andrewcollison/HighTemp/HighTemp/PCB/finished photo.jpg

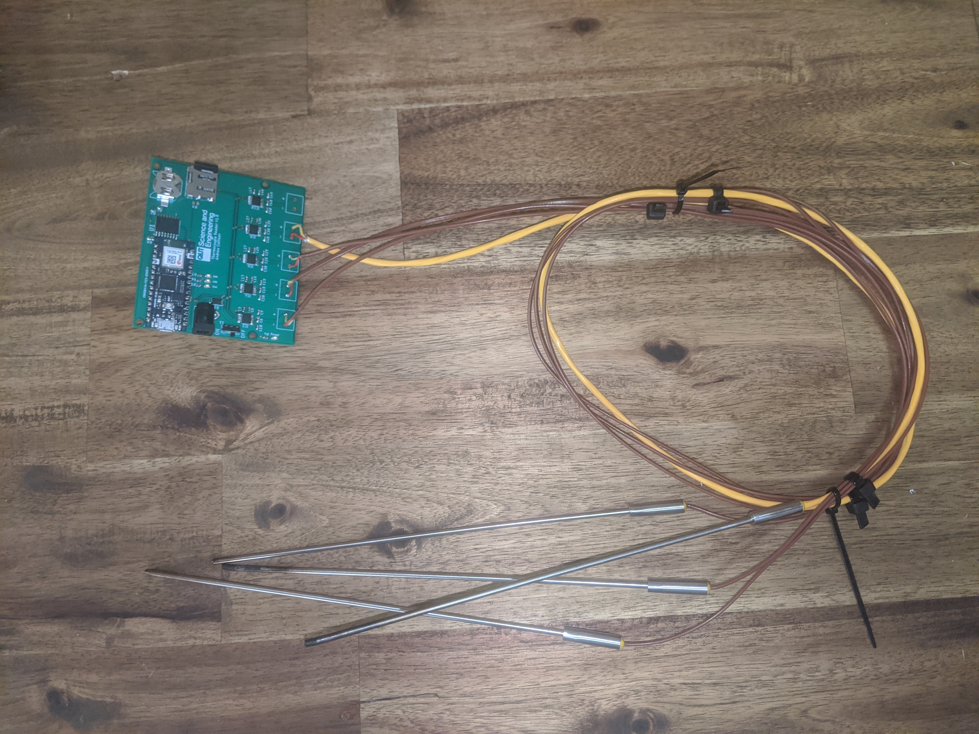
HighTemp/PCB/finished photo.jpg
