andrewcollison/HighTemp/HighTemp/Documentation/Capture.PNG

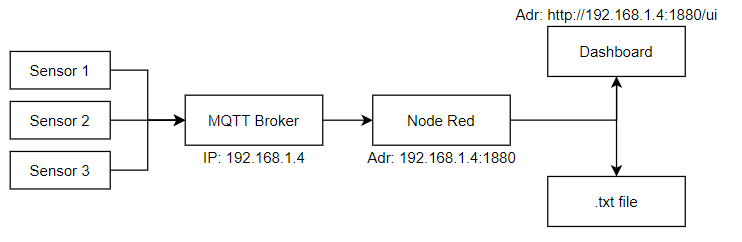
HighTemp/Documentation/Capture.PNG
