andrewcollison/HighTemp/HighTemp/Mechanical/mountingPlate.dxf

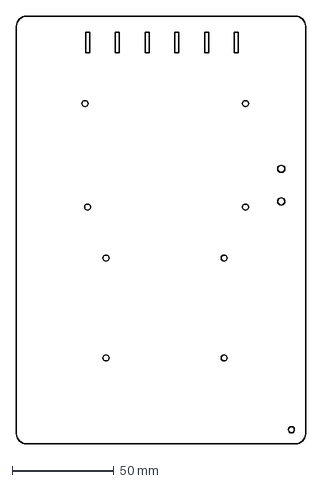
[picture p7: CAD file, 2020-08-11]
HighTemp/Mechanical/mountingPlate.dxf
142.0 x 210.0 mm
