andrewcollison/HighTemp/SaltLevel/CadModels/topAlignment.stl

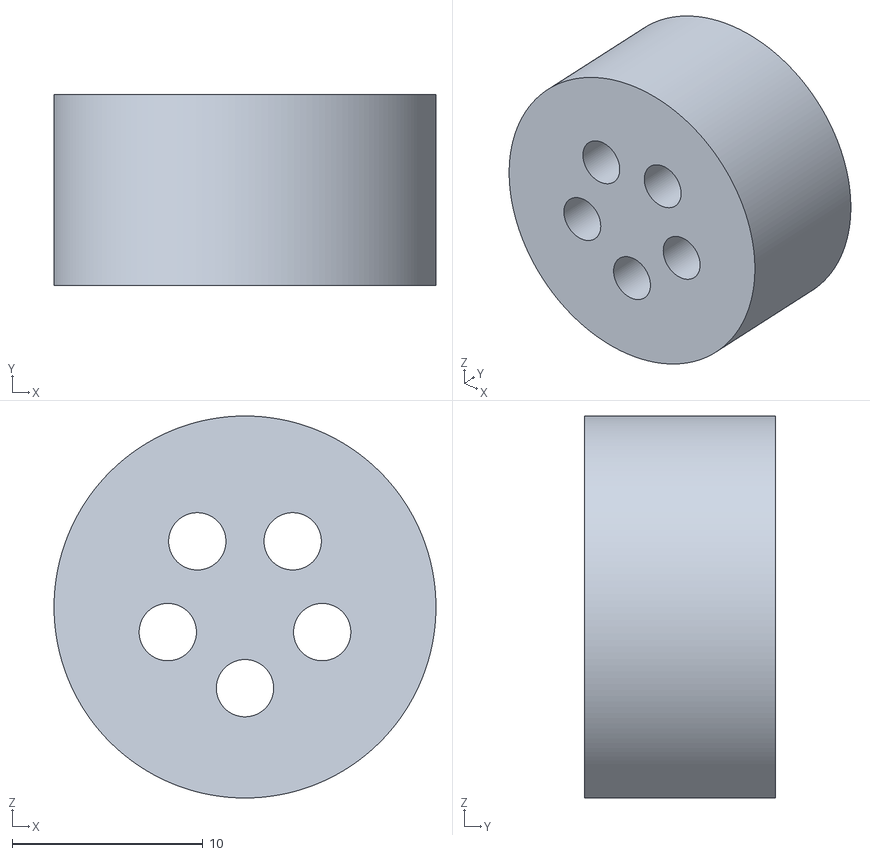
[picture p8: CAD file, 2021-02-08]
SaltLevel/CadModels/topAlignment.stl
20.0 x 10.0 x 20.0
