andrewcollison/HighTemp/SaltLevel/CadModels/BottomAlignment.stl

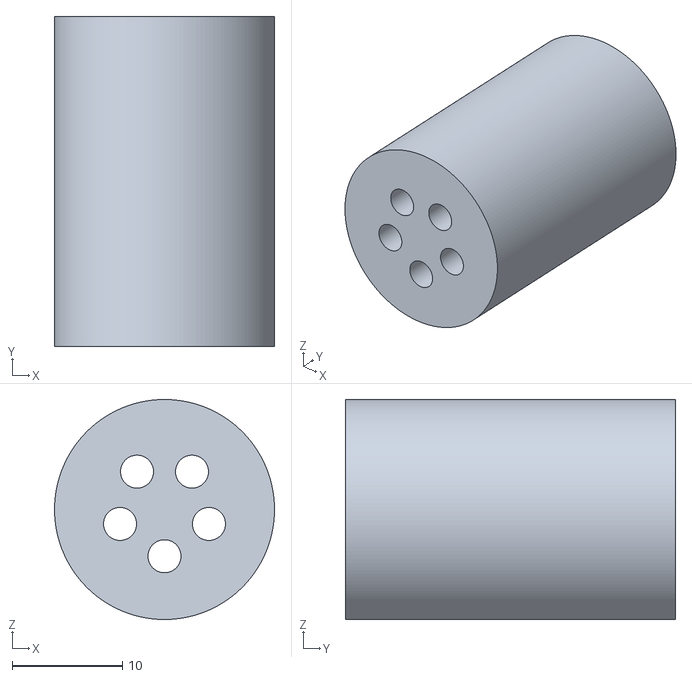
[picture p9: CAD file, 2021-02-08]
SaltLevel/CadModels/BottomAlignment.stl
20.0 x 30.0 x 20.0
