andrewcollison/HighTemp/SaltLevel/CadModels/probeAlignment.dxf

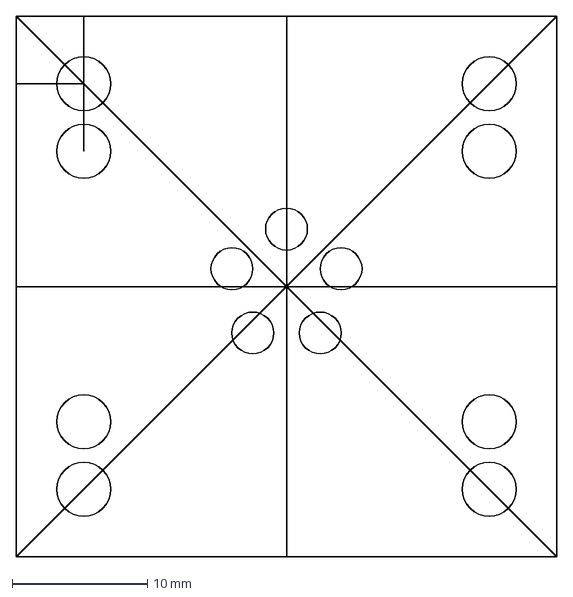
[picture p10: CAD file, 2021-02-08]
SaltLevel/CadModels/probeAlignment.dxf
40.0 x 40.0 mm
