andrewcollison/HighTemp/SaltLevel/CadModels/mouldLeft.stl

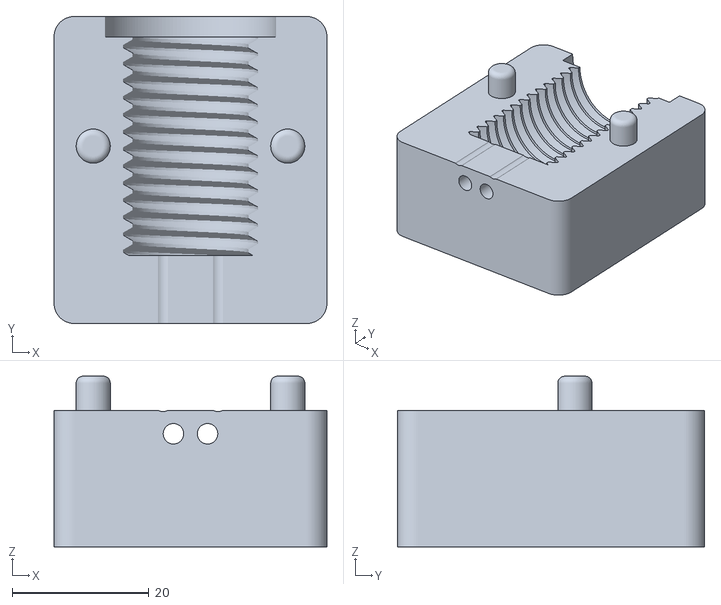
[picture p11: CAD file, 2021-02-03]
SaltLevel/CadModels/mouldLeft.stl
40.0 x 45.0 x 25.0
