andrewcollison/HighTemp/SaltLevel/CadModels/mouldRight.stl

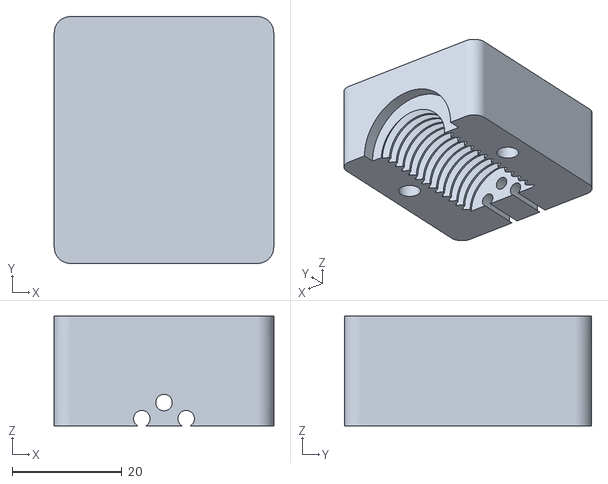
[picture p12: CAD file, 2021-02-03]
SaltLevel/CadModels/mouldRight.stl
40.0 x 45.0 x 20.0
