andrewcollison/HighTemp/(list of files, cad)

Other CAD files:
SaltLevel/CadModels/SaltLevelProbe v2.f3d
