andrewcollison/HighTemp/CentralNodeLogger/CalibrationTest/HeatingUp/dmmTempData.csv

Serial Number | MY59420041
Model Number | U1272A
Remark | -
Date Time | 3/10/2021 12:24:53 PM
Record | Time | Function | Reading | Range | Unit
1 | 3/10/2021 12:17:18.861 | Temperature {NONE} | 26.0 | °C | °C
2 | 3/10/2021 12:17:19.861 | Temperature {NONE} | 26.0 | °C | °C
3 | 3/10/2021 12:17:20.863 | Temperature {NONE} | 26.0 | °C | °C
4 | 3/10/2021 12:17:21.864 | Temperature {NONE} | 26.0 | °C | °C
5 | 3/10/2021 12:17:22.865 | Temperature {NONE} | 26.0 | °C | °C
6 | 3/10/2021 12:17:23.867 | Temperature {NONE} | 26.0 | °C | °C
7 | 3/10/2021 12:17:24.868 | Temperature {NONE} | 26.0 | °C | °C
8 | 3/10/2021 12:17:25.869 | Temperature {NONE} | 26.0 | °C | °C
9 | 3/10/2021 12:17:26.870 | Temperature {NONE} | 26.0 | °C | °C
10 | 3/10/2021 12:17:27.871 | Temperature {NONE} | 26.0 | °C | °C
11 | 3/10/2021 12:17:28.873 | Temperature {NONE} | 26.1 | °C | °C
12 | 3/10/2021 12:17:29.875 | Temperature {NONE} | 26.1 | °C | °C
13 | 3/10/2021 12:17:30.876 | Temperature {NONE} | 26.1 | °C | °C
14 | 3/10/2021 12:17:31.877 | Temperature {NONE} | 26.0 | °C | °C
15 | 3/10/2021 12:17:32.878 | Temperature {NONE} | 26.0 | °C | °C
16 | 3/10/2021 12:17:33.879 | Temperature {NONE} | 26.0 | °C | °C
17 | 3/10/2021 12:17:34.880 | Temperature {NONE} | 26.0 | °C | °C
18 | 3/10/2021 12:17:35.881 | Temperature {NONE} | 26.0 | °C | °C
19 | 3/10/2021 12:17:36.883 | Temperature {NONE} | 26.1 | °C | °C
20 | 3/10/2021 12:17:37.884 | Temperature {NONE} | 26.1 | °C | °C
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
305 | 3/10/2021 12:22:23.202 | Temperature {NONE} | 95.5 | °C | °C
306 | 3/10/2021 12:22:24.202 | Temperature {NONE} | 95.8 | °C | °C
307 | 3/10/2021 12:22:25.204 | Temperature {NONE} | 96.1 | °C | °C
308 | 3/10/2021 12:22:26.204 | Temperature {NONE} | 96.3 | °C | °C
309 | 3/10/2021 12:22:27.205 | Temperature {NONE} | 96.5 | °C | °C
310 | 3/10/2021 12:22:28.206 | Temperature {NONE} | 96.8 | °C | °C
311 | 3/10/2021 12:22:29.207 | Temperature {NONE} | 96.9 | °C | °C
312 | 3/10/2021 12:22:30.209 | Temperature {NONE} | 97.2 | °C | °C
313 | 3/10/2021 12:22:31.210 | Temperature {NONE} | 97.3 | °C | °C
314 | 3/10/2021 12:22:32.212 | Temperature {NONE} | 97.5 | °C | °C
315 | 3/10/2021 12:22:33.213 | Temperature {NONE} | 97.7 | °C | °C
316 | 3/10/2021 12:22:34.214 | Temperature {NONE} | 97.9 | °C | °C
317 | 3/10/2021 12:22:35.215 | Temperature {NONE} | 98.0 | °C | °C
