andrewcollison/HighTemp/HighTemp/Software/test1.png

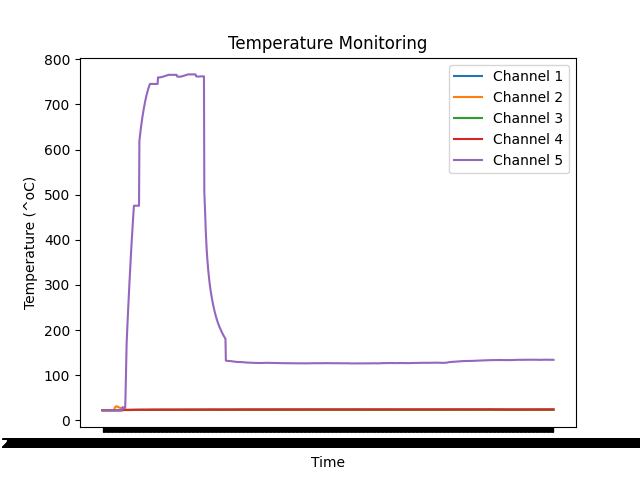
HighTemp/Software/test1.png
