andrewcollison/HighTemp/HighTemp/PCB/HighTempSCH.pdf

## Temperature Sensing

## Micro SD Storage

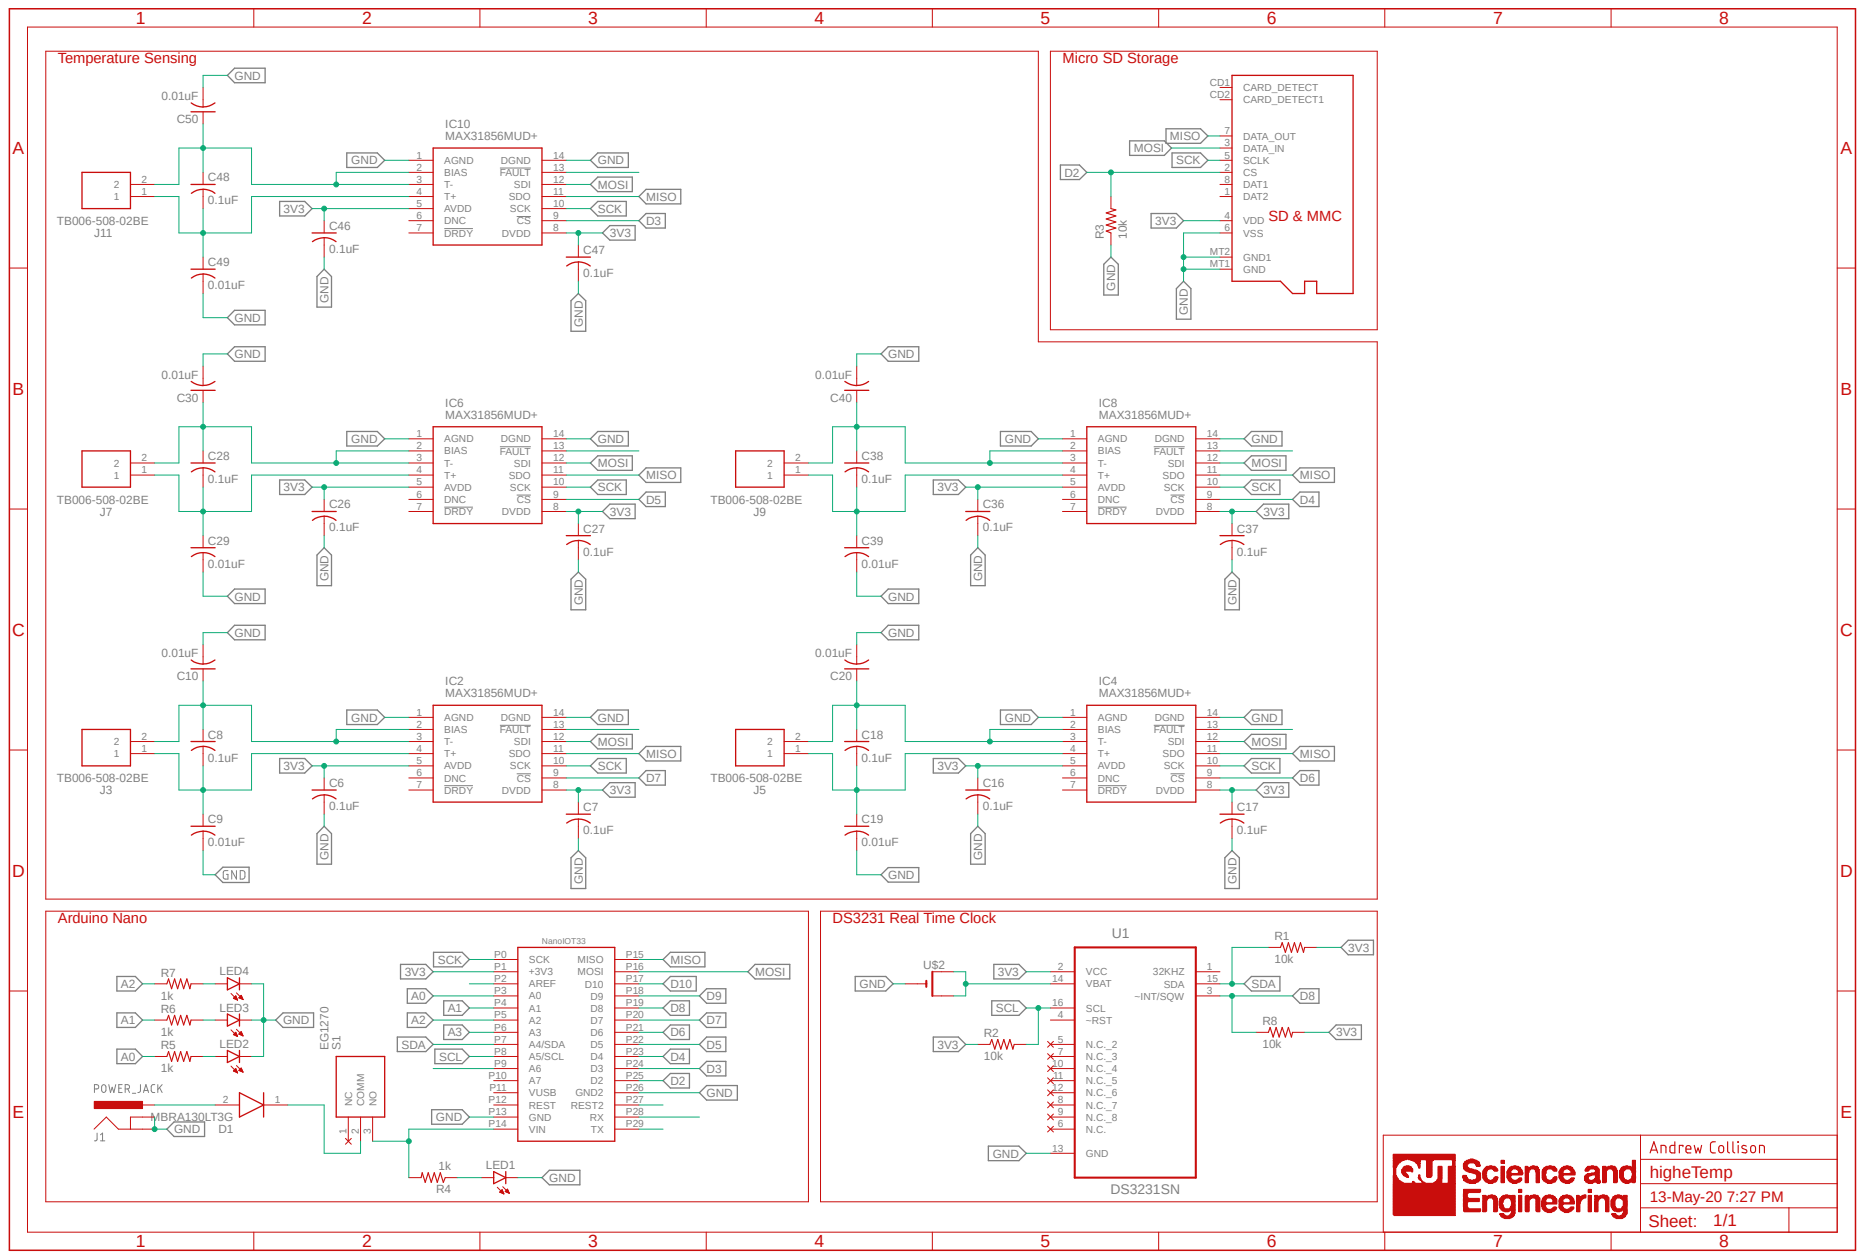
[picture p14: page 1]

AVDD 5
