andrewcollison/HighTemp/Pressure/VoltageScale.asc

R1: res; 47k
R2: res; 100k
V1: voltage; PULSE(1 5 0 10 0 0.1 1)
Named nets: sig, 0, A0
.tran 10
