andrewcollison/HighTemp/SaltLevel/SpiceSim/levelSense.asc

Q1: npn; 2N2222
R2: res; 10k
R3: res; 1k
S1: sw; MYSW
V1: voltage; PULSE(0 3.3 0 0.001 0.001 1 1 5)
V2: voltage; PULSE(0 3.3 1 0.001 0.001 1 2 5)
Named nets: 0, 3V3, D1, Von
.tran 10
.model MYSW SW(Ron=1 Roff=1Meg Vt=.5 Vh=-.4)
