andrewcollison/HighTemp/SaltCorrosion/SpiceSim/const_current.asc

Q1: npn; 2N2222
R1: res; 100k
R2: res; 100k
R5: res; {R}
R6: res; 2700
R9: res; 100k
R10: res; 100k
U1: LT1013
V1: voltage; 3.3
V2: voltage; 0.57
V4: voltage; 2.2
Named nets: 0, 3V3, ADC, VHigh, VLow, 2V2
.tran 10
.param R 10
