andrewcollison/HighTemp/HighTemp/PCB/higheTemp.brd

## EAGLE design HighTemp/PCB/higheTemp.brd (2020-07-14)

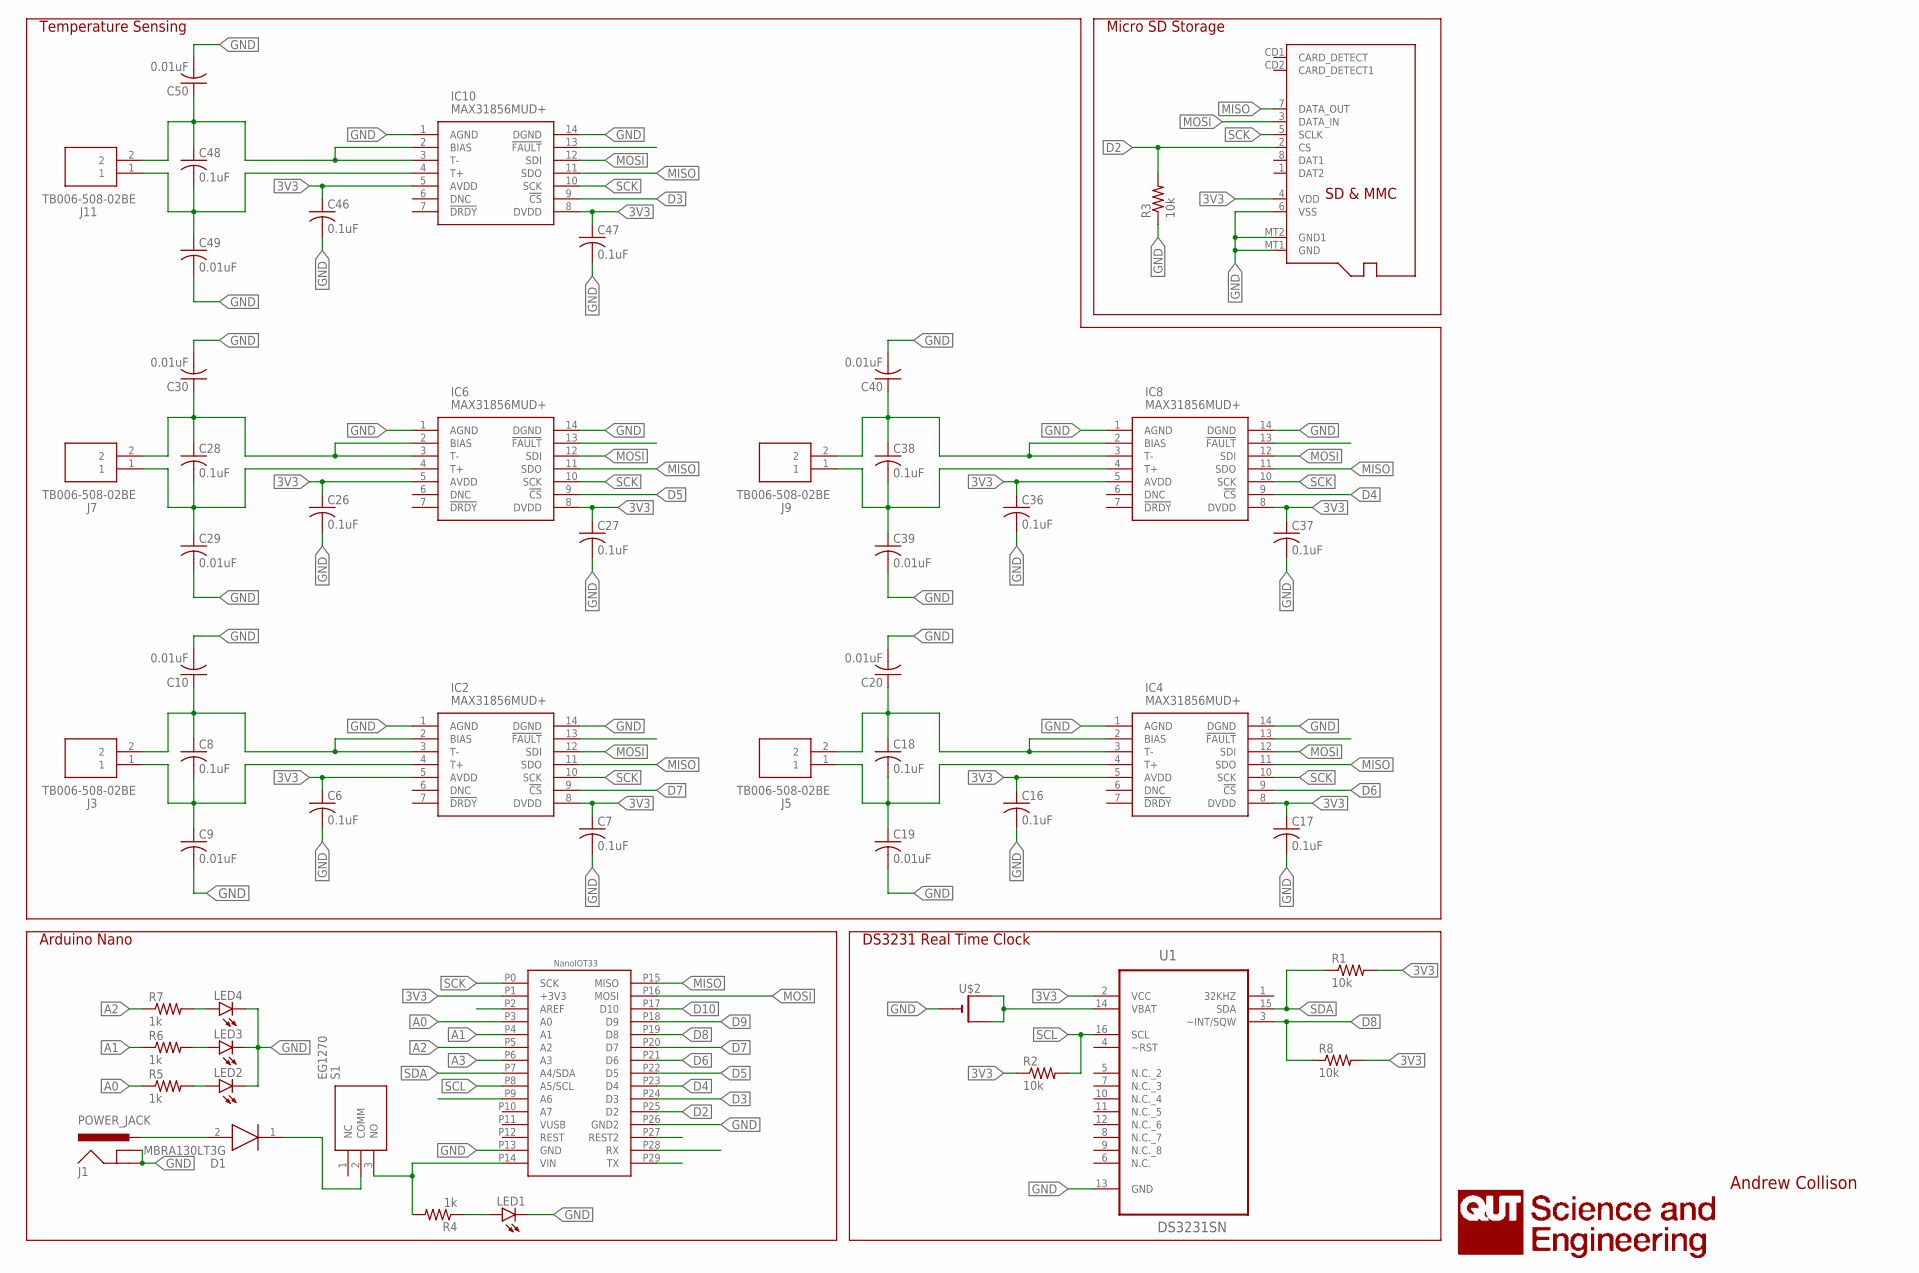
[picture p15: schematic higheTemp.sch]

Parts:
C6, C7, C8, C16, C17, C18, C26, C27, C28, C36, C37, C38, C46, C47, C48: 0.1uF; C0603
C9, C10, C19, C20, C29, C30, C39, C40, C49, C50: 0.01uF; C0603
D1: MBRA130LT3G; DIOM5226X220N
IC2, IC4, IC6, IC8, IC10: MAX31856MUD+; SOP65P640X110-14N
J1: POWER_JACK; POWER_JACK_PTH
J3, J5, J7, J9, J11: TB006-508-02BE; TB00650802BE
LED1, LED2, LED3, LED4: LEDCHIPLED_0805; CHIPLED_0805
R1, R2: 10k; R0603
R3, R8: 10k; R0805
R4, R5, R6, R7: 1k; R0603
S1: EG1270
U1: DS3231SN; SOIC127P1032X265-16N
U$1: NANO33IOT
U$2: CR1220SMT; CR1220-SMD
U$3: MICROSD

Connections:
3V3: C6.1, C7.1, C16.1, C17.1, C26.1, C27.1, C36.1, C37.1, C46.1, C47.1, IC2.5 (AVDD), IC2.8 (DVDD), IC4.5 (AVDD), IC4.8 (DVDD), IC6.5 (AVDD), IC6.8 (DVDD), IC8.5 (AVDD), IC8.8 (DVDD), IC10.5 (AVDD), IC10.8 (DVDD), R1.2, R2.1, R8.2, U1.2 (VCC), U$1.P1 (+3V3), U$3.4 (VDD)
A0: R5.1, U$1.P3 (A0)
A1: R6.1, U$1.P4 (A1)
A2: R7.1, U$1.P5 (A2)
A3: U$1.P6 (A3)
D2: R3.2, U$1.P25 (D2), U$3.2 (CS)
D3: IC10.9 (!CS), U$1.P24 (D3)
D4: IC8.9 (!CS), U$1.P23 (D4)
D5: IC6.9 (!CS), U$1.P22 (D5)
D6: IC4.9 (!CS), U$1.P21 (D6)
D7: IC2.9 (!CS), U$1.P20 (D7)
D8: R8.1, U1.3 (~INT/SQW), U$1.P19 (D8)
D9: U$1.P18 (D9)
D10: U$1.P17 (D10)
GND: C6.2, C7.2, C9.2, C10.2, C16.2, C17.2, C19.2, C20.2, C26.2, C27.2, C29.2, C30.2, C36.2, C37.2, C39.2, C40.2, C46.2, C47.2, C49.2, C50.2, IC2.1 (AGND), IC2.14 (DGND), IC4.1 (AGND), IC4.14 (DGND), IC6.1 (AGND), IC6.14 (DGND), IC8.1 (AGND), IC8.14 (DGND), IC10.1 (AGND), IC10.14 (DGND), J1.GND, J1.GNDBREAK, LED1.C, LED2.C, LED3.C, LED4.C, R3.1, U1.13 (GND), U$1.P13 (GND), U$1.P26 (GND2), U$2.-, U$3.6 (VSS), U$3.MT1 (GND), U$3.MT2 (GND1)
MISO: IC2.11 (SDO), IC4.11 (SDO), IC6.11 (SDO), IC8.11 (SDO), IC10.11 (SDO), U$1.P15 (MISO), U$3.7 (DATA_OUT)
MOSI: IC2.12 (SDI), IC4.12 (SDI), IC6.12 (SDI), IC8.12 (SDI), IC10.12 (SDI), U$1.P16 (MOSI), U$3.3 (DATA_IN)
unnamed: U1.14 (VBAT), U$2.+$1 (+), U$2.+$2 (+1)
unnamed: D1.2 (A), J1.PWR
unnamed: LED1.A, R4.1
unnamed: D1.1 (K), S1.2 (COMM)
unnamed: R4.2, S1.3 (NO), U$1.P14 (VIN)
unnamed: LED2.A, R5.2
unnamed: LED4.A, R7.2
unnamed: LED3.A, R6.2
SCK: IC2.10 (SCK), IC4.10 (SCK), IC6.10 (SCK), IC8.10 (SCK), IC10.10 (SCK), U$1.P0 (SCK), U$3.5 (SCLK)
SCL: R2.2, U1.16 (SCL), U$1.P8 (A5/SCL)
SDA: R1.1, U1.15 (SDA), U$1.P7 (A4/SDA)
T1+1: C8.2, C9.1, IC2.4 (T+), J3.1
T1+3: C18.2, C19.1, IC4.4 (T+), J5.1
T1+5: C28.2, C29.1, IC6.4 (T+), J7.1
T1+7: C38.2, C39.1, IC8.4 (T+), J9.1
T1+9: C48.2, C49.1, IC10.4 (T+), J11.1
T1-1: C8.1, C10.1, IC2.2 (BIAS), IC2.3 (T-), J3.2
T1-3: C18.1, C20.1, IC4.2 (BIAS), IC4.3 (T-), J5.2
T1-5: C28.1, C30.1, IC6.2 (BIAS), IC6.3 (T-), J7.2
T1-7: C38.1, C40.1, IC8.2 (BIAS), IC8.3 (T-), J9.2
T1-9: C48.1, C50.1, IC10.2 (BIAS), IC10.3 (T-), J11.2

Notes on the sheet:
Arduino Nano
Temperature Sensing
DS3231 Real Time Clock
Micro SD Storage
Andrew Collison

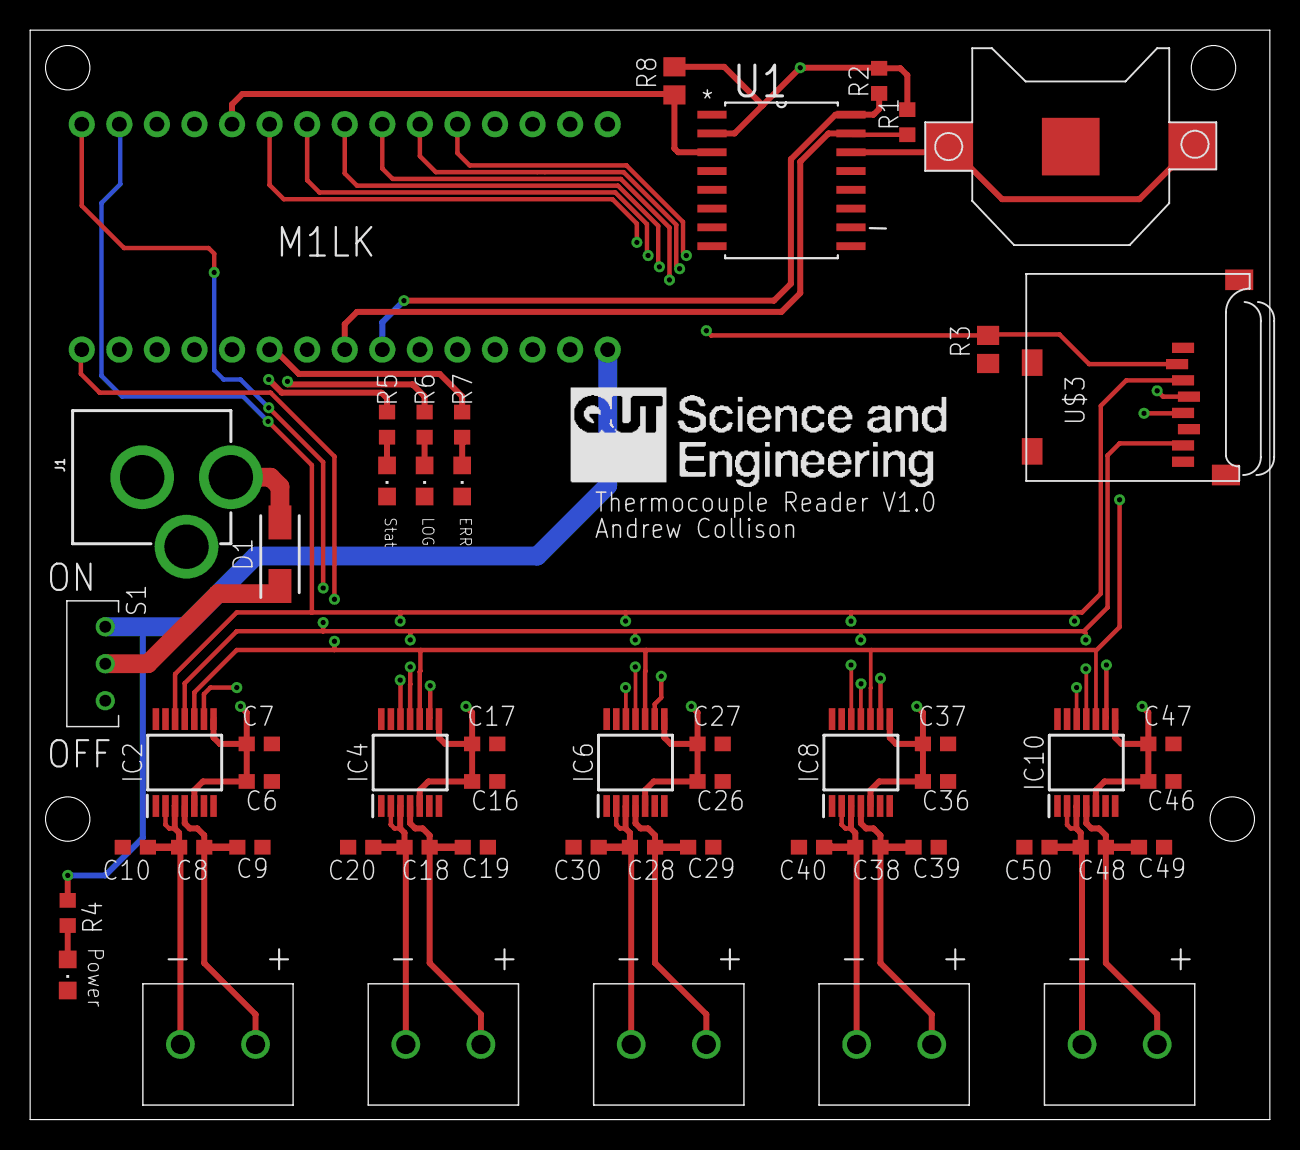
[picture p16: board higheTemp.brd from above]

Board: 4 copper layers, 83.8 x 73.7 mm, 54 parts (0 on the bottom side), 35 nets.
