andrewcollison/HighTemp/HighTemp/Software/MQTTsystem.py

import pandas as pd 
import numpy as np 
import datetime
import paho.mqtt.client as mqtt

fileName = 'officeTest.txt'

def writeFile(filename, data):
	file = open(filename, "a")
	file.write(data)
	file.close()

def on_connect(client, userdata, flags, rc):
  print("Connected with result code "+str(rc))
  client.subscribe("topic/temp1")

def on_subscribe(client, userdata, mid, granted_qos):
    print("Subscribed: "+ str(mid) +" "+ str(granted_qos))

def on_message(client, userdata, msg):
    # print(msg.topic+" "+str(msg.qos)+" "+str(msg.payload))
    currTime = datetime.datetime.now()
    data = str(msg.payload, 'utf-8')
    logString = str(currTime) + ", " + msg.topic + ", " + data + "\n"
    writeFile(fileName, logString)
    print(logString)
       
 
client = mqtt.Client()
client.on_subscribe = on_subscribe
client.on_message = on_message
client.connect("192.168.1.4", 1883)
# client.subscribe("temp1", qos=1)
client.subscribe([("temp1", 1), ("temp2", 1)])
client.loop_forever()
