andrewcollison/HighTemp/(commit log)

2020-07-14 Added PCB design files and arduino code for logger
    [higheTemp.brd, higheTemp.sch]
2020-07-14 Added mechanical drawing
    DXF file for the mounting plate that holds a raspberry pi and the high temp PCB
    [mountingPlate.dxf]
2020-07-15 Updated sensor firmware and python serial
    Added in the 5th channel for the temp logger and re factored the python serial code
2020-07-17 Data acquisition test
    run a couple of tests over night to test stability and reliability
    [PiSensorRead.py, visData.py]
2020-07-20 MQTT Implementation
    Started a new arduino script that publishes the results to an MQTT server. Works on all 5 sensors and is ready for testing in the lab.
2020-07-20 Python MQTT
    Added a python script to read from the mqtt broker
    [MQTTsystem.py]
2020-07-21 Lab Setup
    Updated arduino code to work with laboratory network. Setup MQTT for the lab
2020-07-24 Visdata Update and Lab Integration
    Updated vis data script to format time and axis labes correctly. successfully integrated system into the e424 lab. Waiting on QUT network connections to allow remote access.
    [visData.py]
2020-07-29 Slimmed down arduino code
    Removed functions for the rtc and sd card as they are not needed when data is being communicated over mqtt
2020-08-11 Update
    syncing new laptop
    [mountingPlate.dxf]
2020-09-14 Testing of second temperature sensor
    Made a test file to test sensors without needing to connect to the mqtt server.
    Second sensor is completed and ready for lab integration.
2020-09-15 Pressure Sensor
    Restructure project to include development of a pressure sensor.
    [higheTemp.brd, higheTemp.sch, mountingPlate.dxf]
2020-09-15 Pressure Sensor Code
    Arduino code written for pressure sensor to integrate into existing mqtt system
2020-11-11 Pressure Testing
    Added a script to test the pressure sensors
2020-11-11 Pressure Testing
    Started arduino code for pressure testing
2020-11-12 Test code
    added all functions to map pressure values with floating point precision
2020-11-12 Pressure Test
    Tested pressure sensors up to 0.130MPa successfully. Data recorded on the arduono is accurate to 0.005MPa. Reading were unstable so will need to take average values.
    [pressure_test.ino]
2020-11-13 Averages and MQTT
    Added function to average reading of the adc accross all the used analogue pins and convert that into pressure. The reading on the arduino and the pressure sensor now line up for the most part. 100 samples are taken.
    Also integrated the code into the mqtt frame work so it will work with the node red server in E424.
2020-11-13 Enclosure Design
    File for laser cutting enclosure for pressuresense pcb v1.0
2020-11-13 Deployed Pressure Sensor
    Pressure sensor one is deployed in E424. Is only ready from channel one. Taking the average of 50 samples.
2021-01-09 User Interface
    Started developing the user interface for various sensors
2021-01-10 UI Interface
    Serial connection setup, can now enter the comport to connect and it will start printing out the data to the LCD screens
2021-01-19 Pressure Sense
2021-01-21 Ui for raspberry pi touch screen
    Started development of the user interface for the raspberry pi touch screen. Will display data in real time collected from the hightemp and pressure sensors over serial
2021-01-24 PiUi
    Updated user interface to include a live graph of data being read out. Added in ui elements for connecting second sensor.
    [test1.csv]
2021-01-26 Package errors
    errors with numpy and pandas packages on the raspberry pi
2021-01-26 Roll back to working
    [test1.csv]
2021-01-26 Roll back 2
    [test1.csv]
2021-01-27 PiUi: Live graph
    Live graph updated to only show set number of data points to prevent memory issues etc. No way to work around showing datetime value on live plot as the package does not support it
    [test1.csv]
2021-01-27 PiUi
    Added logging for dual comports. Displays two live plots
    [test1.csv, test2.csv]
2021-02-03 Salt Level Sensor
    Added the spice model for the electronics of the level sensor along with the cad model and stl files for printing.
    [SaltLevelProbe v2.f3d, mouldLeft.stl, mouldRight.stl]
2021-02-05 Corrosion Monitor
    Added spice simulation files for new corrosion sensor
2021-02-08 Post Process Data
    Small script to visualise data collected from raspberry pi sensor monitor.
2021-02-08 Probe Alignment
    Designed probe alignment jig to keep level sensor probe legs straight
    [BottomAlignment.stl, probeAlignment.dxf, topAlignment.stl]
2021-02-24 Level Sensor Code
    Added arduino code for the level sense PCB. Code sends data over serial, error on channel 2 needs further investigation. All other channels working perfectly.
    [levelSense.ino]
2021-02-25 Central Node
    Started writing code to log data on a central node. Uses multithreading to read all serial ports simultaneously and log them into a txt file. Also has error handling for disconnected com ports. Will integrate into a sql database at some point
    [PiSensorRead.py, levelSense.ino]
2021-02-25 Central Node: Error Fix
    Fixed error with package import for use on linux based OS
    [PiSensorRead.py]
2021-03-02 Testing
    Both temperature and and salt level sensors are working and data is being logged to the central logging node. Updated error handling code.
    [testExport.csv]
2021-03-03 Quality of Life
    Preparing for handover. Code has been commented and organised into folders. Started to write the documentation for the sensor box thingo
2021-03-10 Calibration Data
    Run a calibration test
    [dmmTempData.csv, dmmTempDataCool.csv, testExport.csv]
2021-03-19 Central data node update
    adjust print statements and error messages to declutter the command line
    [PiSensorRead.py]
2021-03-19 Updated documentation
    Added wiring diagram for the sodium level sensor to the documentation.
